MRDuzcar/lora-fan-controller/mechanical/Fan case.stl

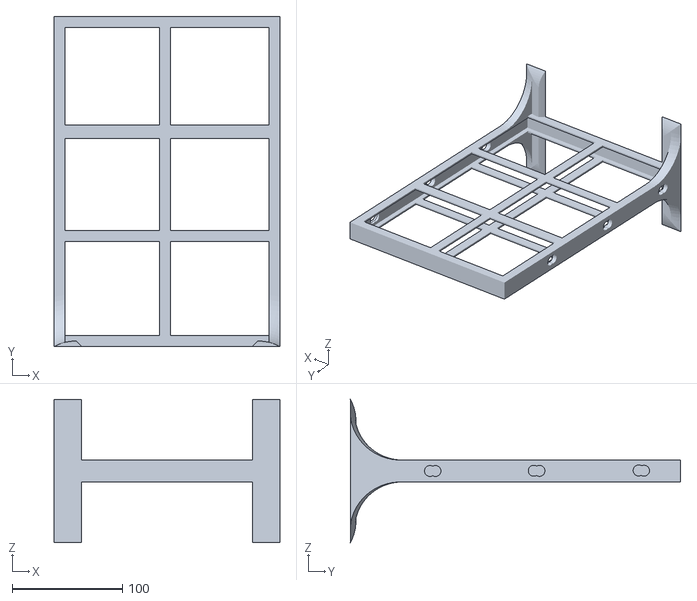
[picture p3: CAD file, 2026-10-10]
mechanical/Fan case.stl
205.0 x 300.0 x 130.0
