MRDuzcar/lora-fan-controller/Hardware/SCH_Receiver_2026-10-13.pdf

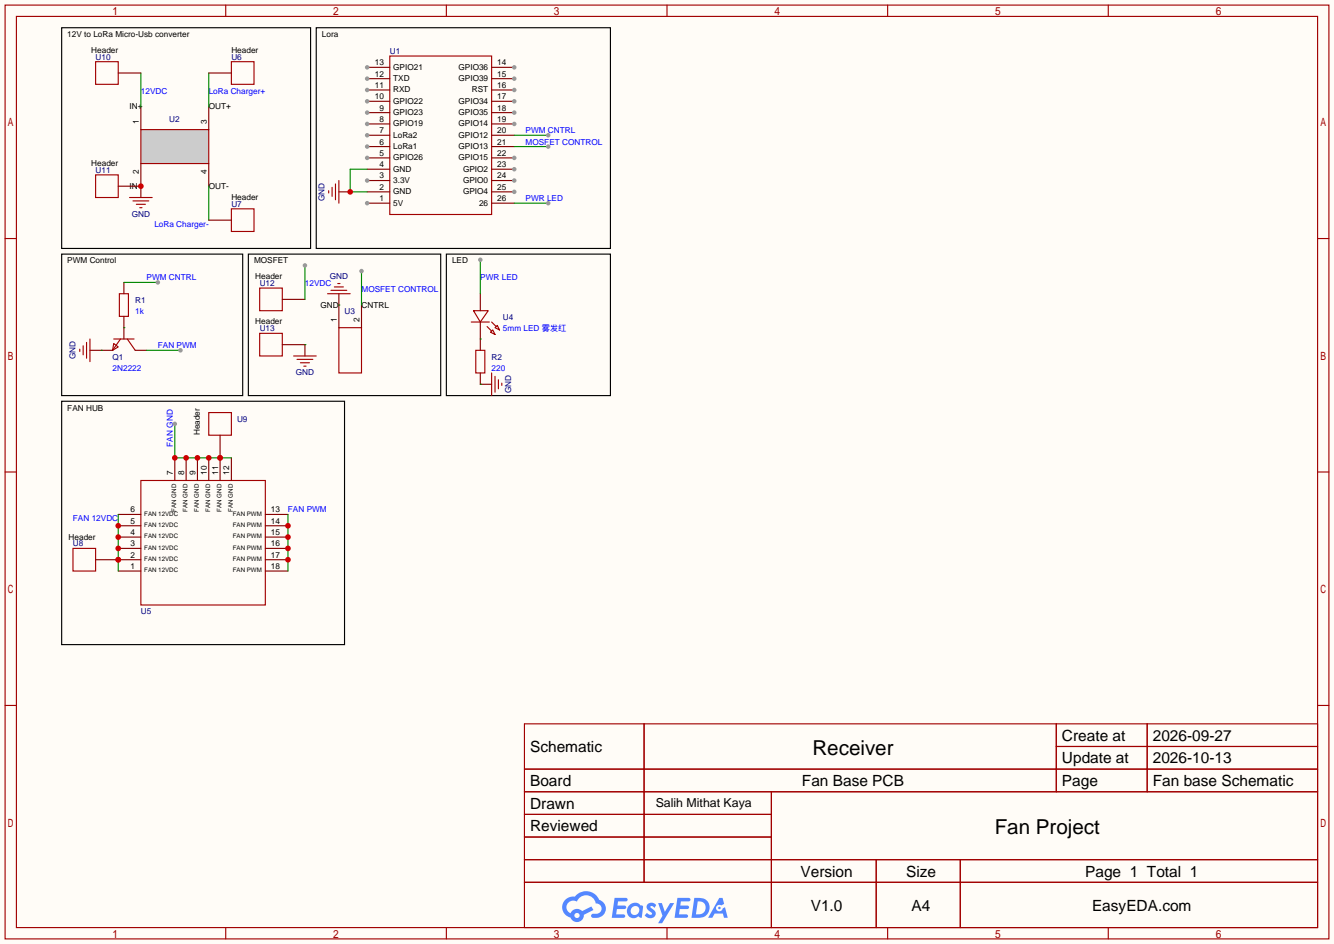
[picture p4: page 1]

12V to LoRa Micro-Usb converter
Header

Schematic | Receiver | Create at | 2026-09-27

Update at | 2026-10-13

Board | Fan Base PCB | Page | Fan base Schematic
Drawn | Salih Mithat Kaya | Fan Project
Reviewed

Version | Size | Page 1 Total 1
V1.0 | A4 | EasyEDA.com
