MRDuzcar/lora-fan-controller/Hardware/SCH_Remote_2026-10-13.pdf

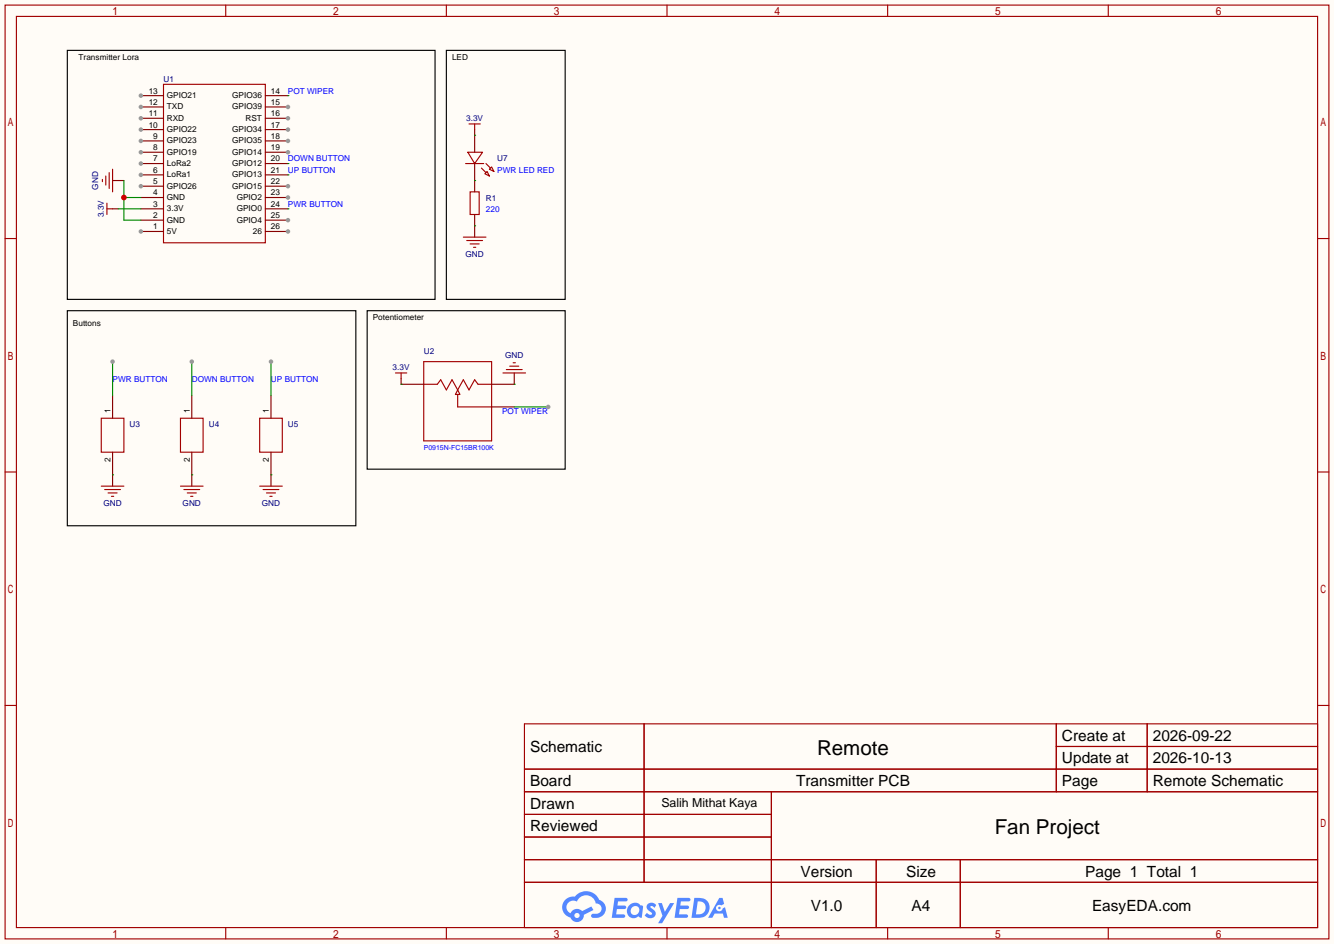
[picture p5: page 1]

Schematic | Remote | Create at | 2026-09-22

Update at | 2026-10-13

Board | Transmitter PCB | Page | Remote Schematic
Drawn | Salih Mithat Kaya | Fan Project
Reviewed

Version | Size | Page 1 Total 1
V1.0 | A4 | EasyEDA.com
